thordin9/rp-pico-fan-controller/enclosure/README.md

# Pico W and BMP280 enclosures

Parametric 3D-printed parts for the Pico W fan controller. The cases are for a controlled indoor room: thin walls, no rain awning, no drip loop, and no radiation-shield louvers. One BMP280 body is printed twice; only the lid label changes (`INT` or `EXT`).

Sources are in [`scad/`](scad/). OpenSCAD meshes are in [`stl/`](stl/), previews in [`renders/`](renders/). Matching FreeCAD models are in [`freecad/`](freecad/).

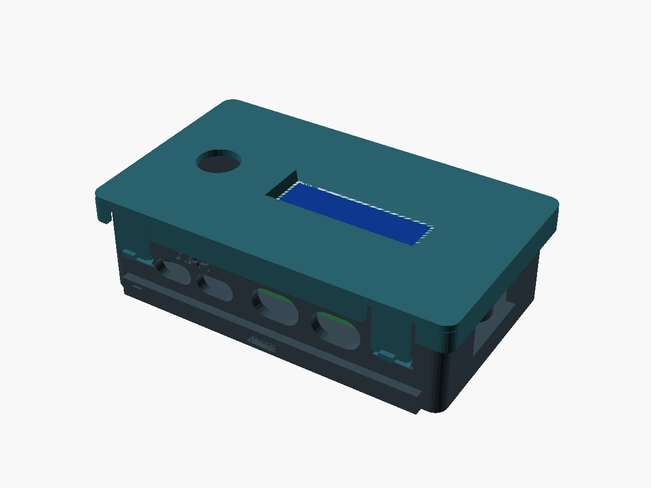
[picture p1: enclosure/renders/pico_case_closed.png]
Pico case, lid closed, OLED in place

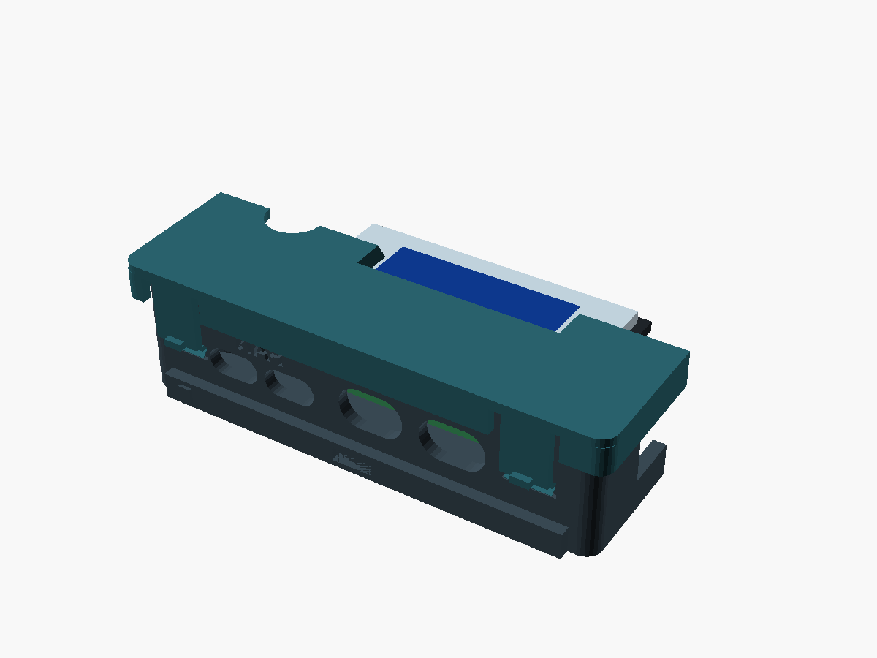
[picture p2: enclosure/renders/pico_case_section.png]
Section through the OLED window

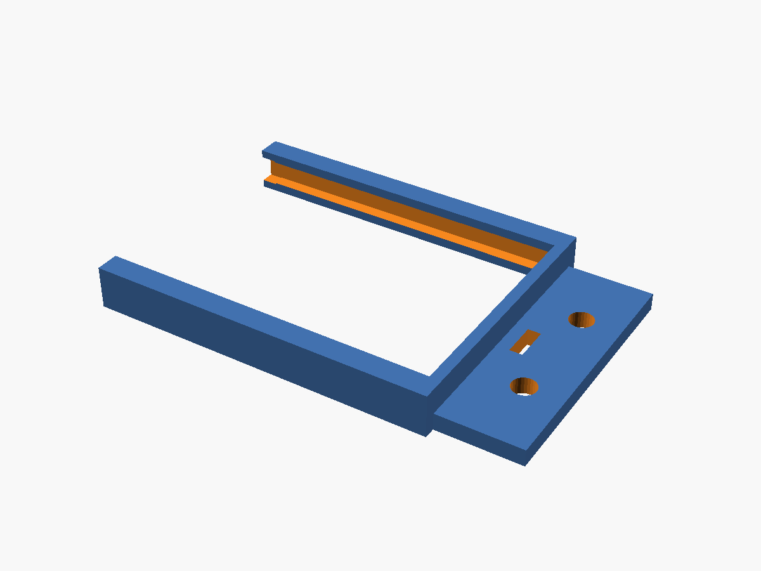
[picture p3: enclosure/renders/mount_pico.png]
Optional Pico wall bracket


## Parts

| Print | STL | Qty | Notes |
| --- | --- | --- | --- |
| Pico case base | [`stl/pico_case_base.stl`](stl/pico_case_base.stl) | 1 | Standoffs, cable exits, slide rails. Flat bottom |
| Pico case lid | [`stl/pico_case_lid.stl`](stl/pico_case_lid.stl) | 1 | Through OLED window with a viewing chamfer, BOOTSEL hole, four latch fingers |
| BMP280 body | [`stl/bmp280_int_body.stl`](stl/bmp280_int_body.stl) | 2 | One print for INT, one for EXT. Same solid |
| BMP280 lid, internal | [`stl/bmp280_int_lid.stl`](stl/bmp280_int_lid.stl) | 1 | Two vents, debossed **INT** |
| BMP280 lid, external | [`stl/bmp280_ext_lid.stl`](stl/bmp280_ext_lid.stl) | 1 | Same vents, debossed **EXT** |
| Pico wall bracket | [`stl/mount_pico.stl`](stl/mount_pico.stl) | 0–1 | Optional. Slides onto the Pico rails |
| BMP280 wall bracket | [`stl/mount_bmp.stl`](stl/mount_bmp.stl) | 0–2 | Optional. One per sensor housing |

`bmp280_ext_body.stl` is the same geometry as the INT body, so either file is the sensor body. `variant` only changes the lid text.

## Old and new outside dimensions

Ears, tabs, the cable awning, and the tall still-air cavity are gone. The slide rails add 1.4 mm per long side and are the only thing the bracket holds. Without a bracket the bottom is flat.

| Part | Previous | Now |
| --- | --- | --- |
| Pico base, body | 63 × 47 × 23 mm | 56.7 × 32.2 × 15.5 mm |
| Pico base, including fixed ears | 63 × 71 × 23 mm | no ears. Rails make the print 56.7 × 35.0 × 15.5 mm |
| Pico lid | 67.3 × 51.3 × 7.0 mm | plate 59.7 × 35.2 × 4.4 mm. Latch fingers bring the print to 59.7 × 36.2 × 10.2 mm |
| BMP280 body | 39.4 × 36.4 × 16.9 mm, plus 16 mm tabs each end (71.4 mm long) | 19.1 × 18.35 × 13.7 mm. Rails make the print 19.1 × 21.15 × 13.7 mm |
| BMP280 lid, INT | 44.3 × 41.3 × 11.9 mm | plate 22.1 × 21.35 × 4.4 mm. Fingers and pull tabs make the print 23.1 × 21.35 × 11.2 mm |
| BMP280 lid, EXT | 46.9 × 43.9 × 11.9 mm, with an eave | same solid as the INT lid, with an EXT label |
| Wall bracket | fixed to the body | separate part. Pico bracket is about 61 × 42 × 6 mm; BMP bracket is about 23 × 28 × 6 mm |

Walls are 1.6 mm (four 0.4 mm perimeters). Floor and lid are 1.2 mm (three perimeters). Pico standoffs are 3.0 mm above the floor. Gutters are 4.0 mm. The antenna end gap is 2.5 mm, with the end wall open across the 14 mm keep-out.

The sensor body used to be 28.6 × 25.6 × 14.5 mm, sized around a 21 × 18 mm board. A purple 15 × 11.5 mm module sat in one corner. The cavity is now that module plus 0.45 mm on the sides and the back, and a 3.2 mm bay on the header edge.

## Dimensions and where they come from

`scad/dimensions.scad` holds every source number. Derived pockets add `fit_clearance` (0.30 mm) per side. OpenSCAD `assert`s fail the export if a pocket, window, snap, or stack-up stops fitting.

| Item | Value | Source |
| --- | --- | --- |
| Pico W PCB | 51 × 21 × 1 mm | Pico W datasheet, section 2 |
| Pico mounting holes | Ø2.1 mm, 47.0 × 11.4 mm pattern | Datasheet figure 3. Insets are (51−47)/2 = 2.0 mm and (21−11.4)/2 = 4.8 mm |
| USB overhang | 1.3 mm typical | Datasheet figure 3. The connector face sits 0.3 mm inside the 1.6 mm end wall, so the plug body stays outside |
| Antenna keep-out | 14 × 9 mm | Datasheet section 2.2.1. The antenna end wall is open across the 14 mm width |
| Header above the PCB | 8.5 mm | Not a datasheet callout. Standard 0.1" pin header. Override `pico_header_above_pcb` |
| BOOTSEL | 7.5 mm from the USB edge of the PCB, on the centreline, Ø7 hole | The drawing does not locate the button. Nudge `pico_bootsel_from_usb_edge` if the hole misses |
| OLED module | 36.0 × 12.5 mm, active area 22.38 × 5.58 mm | Waveshare 0.91" SSD1306 wiki / selection table. The glass is centred on the module (`oled_active_dx` / `oled_active_dy` are 0) |
| OLED window | 22.78 × 5.98 mm through the lid | Active area plus 0.40 mm. A 45° chamfer opens toward the outside face so the pixels stay readable at an angle |
| OLED stack | PCB 1.20 + glass 1.45 = 2.65 mm | Thickness is not published by Waveshare. 1.45 mm is the matching 0.91" 128×32 panel (EastRising ER-OLED0.91-1). Remeasure and set `oled_pcb_t` / `oled_glass_t` |
| BMP280 module | 15 × 11.5 × 1.6 mm, six pins | Purple GY-BMP280-3.3. Sellers list this outline; the repo has no drawing of the hole centres |
| BMP280 mounting holes | Ø2.2 mm, 2.5 mm from each short edge, 2.4 mm from the edge opposite the header | Not on a published drawing. Override `bmp_hole_inset_x` and `bmp_hole_inset_back` if you measure something else. The walls still locate the board if the holes are off |
| BMP280 pin pitch | 2.54 mm, five spaces (12.7 mm) on the 15 mm edge | The 1×6 Dupont shell is 15.24 mm and fits the chamber, not the PCB |
| Walls / floor / lid | 1.6 / 1.2 / 1.2 mm | Four and three 0.4 mm perimeters |
| Slide rail | 1.4 mm thick × 3.2 mm tall | Same section on the Pico case and both sensor bodies. Each rail has a 5.0 × 1.8 mm zip-tie slot and a 0.4 mm detent |

Header plastic width, the micro-USB shell (8.0 × 3.8 mm), and the PH2.0 shroud width (10.5 mm) are named because they are not in those drawings. The PH2.0 plug has to stay narrower than the gap between the Pico header rows (15.24 mm).

The OLED nest is shifted 6 mm toward the antenna so it clears the BOOTSEL hole and the USB shell. In plan it sits inboard of the header plastic (about 0.5 mm). The glass face is against the inner face of the lid, and the window is a hole, not a pocket floor. [`renders/pico_case_closed.png`](renders/pico_case_closed.png) shows the dummy panel through the closed lid. [`renders/pico_case_section.png`](renders/pico_case_section.png) cuts on the active-area centreline.

## Cable routing

Each BMP280 module has six pins: **VCC, GND, SCL, SDA, CSB, SDO**. Tie **CSB to 3V3** before power-up (that forces I2C mode) and **SDO to GND** (address **0x76**). Do this with a wire. The onboard pull resistors are not enough.

- **(a)** A 6-wire cable to the Pico. CSB joins 3V3 pin 36. SDO joins Pico GND.
- **(b)** Short jumpers soldered on the module, CSB to VCC and SDO to GND. The cable stays four wires.

The two boards both end at `0x76`, so they cannot share a bus. The firmware can instead put a sensor at **0x77** on I2C0 when that module's SDO is tied to 3V3. These printed parts are for two `0x76` boards, two buses, and two cable exits. The pin-by-pin wiring is in [docs/wiring.md](../docs/wiring.md).

The sensor housing exit is a through opening, **15.5 × 4.6 mm** with 0.8 mm corners, centred on the pin row. It sits above the slide rails and clear of the bracket. A 1×6 Dupont shell (15.24 mm wide, about 2.5 mm tall) or soldered wires leave through that edge. A bar across the top of the opening bites the side walls and takes one zip tie without filling the hole. [`renders/bmp280_cable_exit.png`](renders/bmp280_cable_exit.png) shows that face.

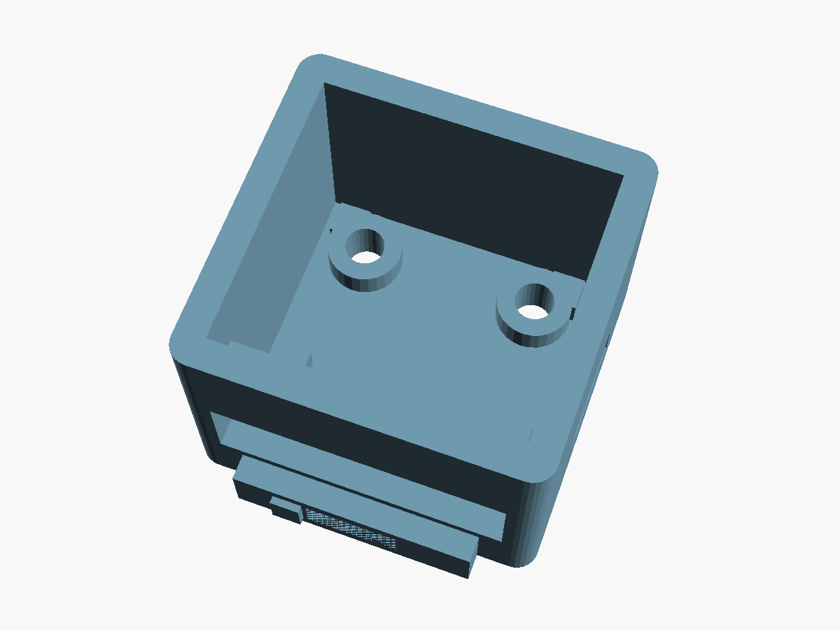
[picture p4: enclosure/renders/bmp280_cable_exit.png]
BMP280 cable exit


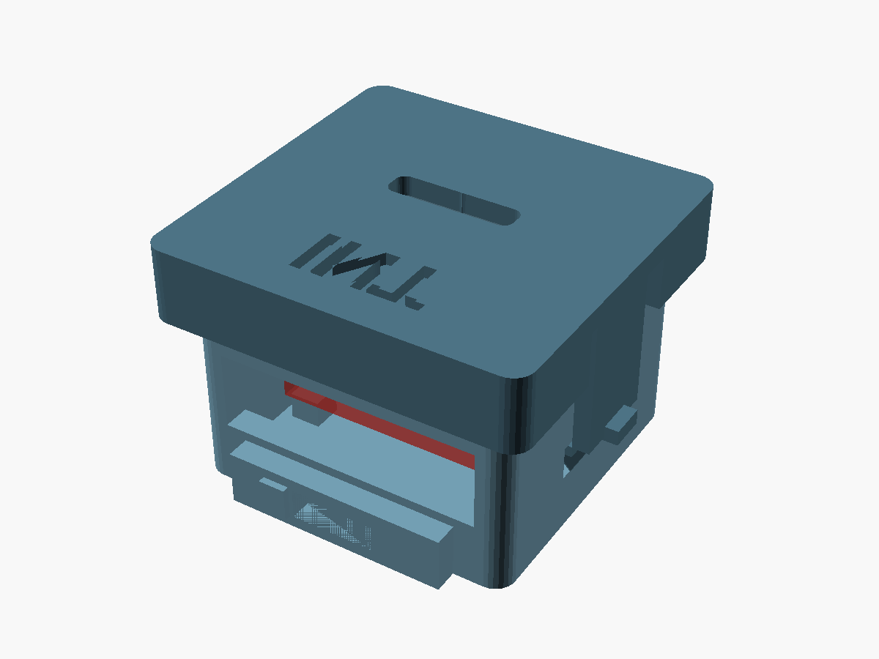
[picture p5: enclosure/renders/bmp280_assembly.png]
BMP280 housing, lid seated


The Pico case has a separate exit for each cable, plus two fan exits and one power exit. INT and EXT are **8.0 × 5.0 mm**, so the 6-wire bundle from option (a) passes after the 1×6 shell stays on the module. The OLED does not use those exits; its PH2.0 lead stays inside the case. Each Pico cleat sits on the top edge of its opening, so the hole stays full height.

| Exit (debossed) | Wall | Lands on | Cable |
| --- | --- | --- | --- |
| **FAN** (two slots) | Cable wall, USB end | GP15–GP18 PWM, GP14–GP11 tach | Split the four fans across the two slots, two fans each. Tach pull-ups are 10 kΩ to Pico **3V3** |
| **INT** | Cable wall | **I2C0: GP4 SDA pin 6, GP5 SCL pin 7** | Internal BMP280. See the pin table below |
| **EXT** | Cable wall, antenna end | **I2C1: GP6 SDA pin 9, GP7 SCL pin 10** | External BMP280. See the pin table below |
| **PWR** | Opposite wall | VSYS and the fan supply | Regulated 5 V into **VSYS (physical pin 39)**, external 12 V for the fans, and the common ground |

### Internal sensor, every module pin

| Module pin | Lands on | Option (a), 6-wire cable out the INT exit | Option (b), jumper on the module |
| --- | --- | --- | --- |
| VCC | Pico 3V3 pin 36 | wire in the cable | wire in the cable |
| GND | Pico GND | wire in the cable | wire in the cable |
| SCL | GP5 pin 7 | wire in the cable | wire in the cable |
| SDA | GP4 pin 6 | wire in the cable | wire in the cable |
| CSB | 3V3, high before power-up | wire in the cable to 3V3 pin 36 | solder CSB to VCC |
| SDO | GND, address `0x76` | wire in the cable to Pico GND | solder SDO to GND |

### External sensor, every module pin

| Module pin | Lands on | Option (a), 6-wire cable out the EXT exit | Option (b), jumper on the module |
| --- | --- | --- | --- |
| VCC | Pico 3V3 pin 36 | wire in the cable | wire in the cable |
| GND | Pico GND | wire in the cable | wire in the cable |
| SCL | GP7 pin 10 | wire in the cable | wire in the cable |
| SDA | GP6 pin 9 | wire in the cable | wire in the cable |
| CSB | 3V3, high before power-up | wire in the cable to 3V3 pin 36 | solder CSB to VCC |
| SDO | GND, address `0x76` | wire in the cable to Pico GND | solder SDO to GND |

The OLED PH2.0 (VCC, GND, SDA, SCL) is plugged inside the case onto the same I2C0 pins as the INT cable: VCC and GND to 3V3 and GND, SDA to GP4, SCL to GP5. It has no CSB or SDO. Parallel the INT cable onto those four points. Do not also connect the EXT cable there. With option (a), the internal CSB shares 3V3 pin 36 and the internal SDO shares a GND pin; they are not OLED signals.

```mermaid
flowchart LR
  subgraph box [Pico case]
    pico["Pico W USB toward the USB opening"]
    oled["OLED 0x3C PH2.0 stays inside"]
  end
  subgraph inside [INT housing in the room]
    bmpI["BMP280 0x76 CSB to 3V3 SDO to GND"]
  end
  subgraph outside [EXT housing in the room]
    bmpE["BMP280 0x76 CSB to 3V3 SDO to GND"]
  end
  fans["12 V fans through the two FAN slots"]
  supply["5 V and 12 V through PWR"]
  pico -->|"INT option a: VCC, GND, SDA GP4 pin 6, SCL GP5 pin 7, CSB to 3V3 pin 36, SDO to GND"| bmpI
  pico -->|"OLED: VCC, GND, SDA, SCL on the same I2C0 points"| oled
  pico -->|"EXT option a: VCC, GND, SDA GP6 pin 9, SCL GP7 pin 10, CSB to 3V3 pin 36, SDO to GND"| bmpE
  pico -->|"FAN: PWM GP15-GP18, tach GP14 GP13 GP12 GP11"| fans
  supply -->|"VSYS pin 39 and common GND"| pico
  supply -->|"12 V to fan pin 2, GND to fan pin 1"| fans
```

Option (b) uses the same exits. CSB and SDO stop at the jumpers on the module, and the cable through INT or EXT is VCC, GND, SCL, SDA.

Physical pin numbers use the Pico pinout with USB at the top: pin 1 is GP0, pin 40 is VBUS. Fan tach pull-ups are 10 kΩ to Pico 3V3 pin 36, one resistor per tach wire.

Fan power and tach rules match the controller [wiring guide](../docs/wiring.md): fans take 12 V from their own supply, never from the Pico; 5 V into VSYS pin 39 only; one common ground. Do not feed 5 V into 3V3 pin 36.

## Where to put the sensors

Both housings are the same shape. Put the **INT** lid on the one that shares the OLED bus, and the **EXT** lid on the one that has I2C1 to itself.

- Out of the fan blast, and away from the motor body, the Pico regulator, and the 12 V wiring.
- Lid up. The board stands on corner pads and two bosses around the M2 holes, so it is not shorted to the plastic. The side walls and the back wall locate it; the header edge stays open for the plug.
- The lid vents are open slots. They are not a weather shield. These parts are for an indoor room.

## Using the case with and without the bracket

The bodies have no mounting ears and no tabs. The bottom is flat, so a case can sit on a desk or take a pad of double-sided tape.

Each long wall has a slide rail with a zip-tie slot (5.0 × 1.8 mm). A tie through that slot holds the case to a grille or a shelf without the bracket.

The bracket is a separate print. Slide it onto the rails from the USB end (Pico) or the cable end (BMP280) until it stops. The 0.4 mm detent is what the jaw flexes over; pull straight back off to remove it. The flange takes two M3 screws or one zip tie. The bracket does not go under the case, so the case still sits flat while the flange sticks out at one end.

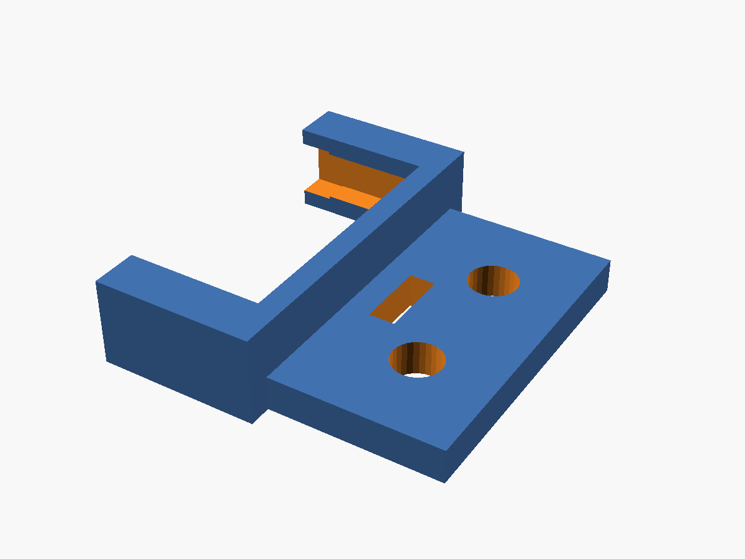
[picture p6: enclosure/renders/mount_bmp.png]
BMP280 bracket


## Hardware

Heat-set inserts are M2, 3.5 mm OD × 3 mm long (short Ruthex-style). The printed hole is Ø3.2 mm × 3.6 mm deep. The lid snaps on; it does not use screws.

| Qty | Fastener | Where |
| --- | --- | --- |
| 4 | M2 insert 3.5 × 3 mm | Pico standoffs, pressed in from **below**, before the board goes in |
| 4 | M2×4 pan head | Down through the Pico's own holes into the standoffs. The insert starts 0.6 mm under the standoff top, so about 2.4 mm of thread enters the pocket. An M2×5 bottoms out |
| 0–6 | M3 pan head, or zip ties | Optional brackets only. Two M3 holes and one zip slot per bracket. Clearance is Ø3.4 mm |
| 0–4 | Zip ties, 5.0 × 1.8 mm slot | Through the slide rails when a bracket is not used |
| 7 | Small zip ties | Five Pico exits (two FAN, INT, EXT, PWR) and one cable cleat in each sensor housing |

The lids snap on. Each finger is 1.0 mm thick, with a 45° lead-in and 0.20 mm of interference once the hook sits in the recess. The BMP280 lid has one finger on each short end (8.45 mm arm). The Pico lid has two fingers on each long side (7.45 mm arm), above the bracket jaw and clear of the cable slots. There is no screw boss on the lids.

To close a lid, press it on until the fingers click. To open it, pinch the pull tabs on the fingers and lift. A fingernail notch on the wall opposite the cable exit is the other way to start the lid off.

## Print settings and orientation

- Nozzle 0.4 mm, layer 0.20 mm, **4 perimeters** on the 1.6 mm walls (3 on the 1.2 mm floor and lid), 4 top/bottom layers, 20% infill.
- PLA or PETG. Indoor parts; colour does not matter for the sensor.
- **No supports.** Bodies sit on the bed as modelled (floor and rails down). Cable slots are horizontal openings. The latch recess is a side pocket.
- Sensor lids and the Pico lid are modelled **outer face down, fingers pointing up**. Print them that way. Do not flip a lid onto its skirt: the hooks would land on the bed. The lead-in is a 45° overhang under 1 mm, and each pull tab sticks out 0.8 mm. The OLED chamfer is the wide opening on the bed and closes at 45°. The debossed INT/EXT mark faces the bed; it is only 0.45 mm deep.
- The Pico lid's OLED clips are small ledges inside the nest. If a clip fails, print that lid slower with more cooling rather than adding support under the nest.
- Brackets print flange-down, jaws up. The groove is open toward the case. The top lip bridges 1.7 mm, which a 0.4 mm nozzle does without support.

## Assembly

1. Press four inserts into the Pico standoffs from the **bottom** of the base. Seat them flush. Do this before the board goes in.
2. Set the Pico on the standoffs, USB toward the USB opening, antenna toward the open end wall. M2×4 down through the Pico holes.
3. Fan leads out the two **FAN** slots, INT cable out **INT**, EXT cable out **EXT**, 5 V and 12 V in through **PWR**. One zip tie per cleat.
4. Plug the OLED into I2C0 (GP4/GP5, 3V3, GND) and slide the module into the lid nest, glass toward the window, PH2.0 toward the USB end. The clips grab the back of the PCB. With the lid closed the active area is the hole in the lid; the chamfer is the wider opening on the outside.
5. Press the Pico lid on until the four fingers click. Pinch a pull tab on each long side to take it off. BOOTSEL is the round hole near the USB end of the lid. The fingernail notch is on the long side opposite the cable wall.
6. Sensor boards sit on the pads, pin row toward the cable slot, chip up. Option (a) sends six wires out the 15.5 × 4.6 mm exit. Option (b) solders CSB to VCC and SDO to GND on the module, and four wires leave. Zip-tie the lead under the bar. Press the lid on until the two end fingers click. Pinch the pull tabs to take it off. The fingernail notch is opposite the cable side.
7. Leave the case on its flat bottom, tape it down, zip-tie it through the rail slots, or slide a bracket on from the open end of the rails and screw the flange to the wall.

## Adjusting the model

From `enclosure/`:

```bash
./export.sh
```

`QUALITY=32 ./export.sh` is a faster mesh. The default is 48. The script refuses a mesh that is not a single shell, and it checks that the USB opening, the separate INT and EXT exits, the FAN and PWR exits, the OLED window, the BOOTSEL hole, the sensor cable slot, and the lid vents are actually open. Each of those cable checks includes a point past the inner face, so a blind recess fails.

Overrides are normal OpenSCAD `-D` flags, for example:

```bash
openscad -D 'fit_clearance=0.40' -D 'variant="EXT"' -D 'part="lid"' \
  -o /tmp/ext.stl --export-format binstl scad/bmp280_housing.scad
```

| Knob | What it does |
| --- | --- |
| `fit_clearance` | Extra room per side on the OLED pocket. Keep it between 0.20 and 0.60 mm |
| `pico_header_above_pcb` | Raise this if your headers are taller than 8.5 mm. The case grows with it |
| `pico_bootsel_from_usb_edge` | Move the BOOTSEL hole along the board. The OLED nest must stay clear of it |
| `oled_pcb_t`, `oled_glass_t` | Stack height if you remeasure the module. The glass is seated against the lid |
| `oled_active_dx`, `oled_active_dy` | Shift the window if the pixels are not centred on your module |
| `bmp_air` | Side and back clearance around the 15 × 11.5 mm module. Keep it between 0.30 and 0.50 mm |
| `bmp_pcb_l`, `bmp_pcb_w` | Module outline if yours is not 15 × 11.5 mm. The body, the lid, and the bracket follow |
| `bmp_header_bay` | Room in front of the pin row for a Dupont plug or soldered wires |
| `bmp_hole_inset_x`, `bmp_hole_inset_back` | Move the M2 holes if you measure different centres |
| `bmp_pcb_t`, `bmp_pin_pitch` | If your module is not 1.6 mm or the row is not 2.54 mm |
| `pico_standoff_h` | More room under the board for solder tails. The datasheet notes solder under the USB connector can hold a bare board off the table |
| `variant`, `part`, `which` | `"INT"` / `"EXT"`, `"body"` / `"lid"` / `"assembly"` / `"section"` / `"closed"`, and `"pico"` / `"bmp"` for the bracket |

`assembly`, `closed`, and `section` are previews, not print files. The Pico section cuts through the OLED centreline and leaves a dummy module in the nest so the chamfer and the glass are visible.
