thordin9/rp-pico-fan-controller/enclosure/freecad/dof-report.txt

pico_case_base	shell	DoF=0	solve=0	fully_constrained=True	redundant=[]	conflicting=[]	malformed=[]	partial=[]	status=Valid
pico_case_base	shell_round	DoF=0	solve=0	fully_constrained=True	redundant=[]	conflicting=[]	malformed=[]	partial=[]	status=Valid
pico_case_base	rail_n	DoF=0	solve=0	fully_constrained=True	redundant=[]	conflicting=[]	malformed=[]	partial=[]	status=Valid
pico_case_base	rail_p	DoF=0	solve=0	fully_constrained=True	redundant=[]	conflicting=[]	malformed=[]	partial=[]	status=Valid
pico_case_base	zip_n	DoF=0	solve=0	fully_constrained=True	redundant=[]	conflicting=[]	malformed=[]	partial=[]	status=Valid
pico_case_base	zip_p	DoF=0	solve=0	fully_constrained=True	redundant=[]	conflicting=[]	malformed=[]	partial=[]	status=Valid
pico_case_base	det_n	DoF=0	solve=0	fully_constrained=True	redundant=[]	conflicting=[]	malformed=[]	partial=[]	status=Valid
pico_case_base	det_p	DoF=0	solve=0	fully_constrained=True	redundant=[]	conflicting=[]	malformed=[]	partial=[]	status=Valid
pico_case_base	cavity	DoF=0	solve=0	fully_constrained=True	redundant=[]	conflicting=[]	malformed=[]	partial=[]	status=Valid
pico_case_base	usb	DoF=0	solve=0	fully_constrained=True	redundant=[]	conflicting=[]	malformed=[]	partial=[]	status=Valid
pico_case_base	usb_round	DoF=0	solve=0	fully_constrained=True	redundant=[]	conflicting=[]	malformed=[]	partial=[]	status=Valid
pico_case_base	antenna	DoF=0	solve=0	fully_constrained=True	redundant=[]	conflicting=[]	malformed=[]	partial=[]	status=Valid
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
bmp280_ext_body	screw_1	DoF=0	solve=0	fully_constrained=True	redundant=[]	conflicting=[]	malformed=[]	partial=[]	status=Valid
bmp280_ext_body	bar	DoF=0	solve=0	fully_constrained=True	redundant=[]	conflicting=[]	malformed=[]	partial=[]	status=Valid
bmp280_ext_body	lr0	DoF=0	solve=0	fully_constrained=True	redundant=[]	conflicting=[]	malformed=[]	partial=[]	status=Valid
bmp280_ext_body	lr1	DoF=0	solve=0	fully_constrained=True	redundant=[]	conflicting=[]	malformed=[]	partial=[]	status=Valid
RESULT	bmp280_ext_body	volume_solid=1806.134	volume_openscad_stl=1808.635	delta=-2.501	rel=0.001383	bbox_delta=0.0000	probes=6
bmp280_int_lid	plate	DoF=0	solve=0	fully_constrained=True	redundant=[]	conflicting=[]	malformed=[]	partial=[]	status=Valid
bmp280_int_lid	plate_round	DoF=0	solve=0	fully_constrained=True	redundant=[]	conflicting=[]	malformed=[]	partial=[]	status=Valid
bmp280_int_lid	skirt	DoF=0	solve=0	fully_constrained=True	redundant=[]	conflicting=[]	malformed=[]	partial=[]	status=Valid
bmp280_int_lid	skirt_round	DoF=0	solve=0	fully_constrained=True	redundant=[]	conflicting=[]	malformed=[]	partial=[]	status=Valid
bmp280_int_lid	skirt_void	DoF=0	solve=0	fully_constrained=True	redundant=[]	conflicting=[]	malformed=[]	partial=[]	status=Valid
bmp280_int_lid	ls0	DoF=0	solve=0	fully_constrained=True	redundant=[]	conflicting=[]	malformed=[]	partial=[]	status=Valid
bmp280_int_lid	ls1	DoF=0	solve=0	fully_constrained=True	redundant=[]	conflicting=[]	malformed=[]	partial=[]	status=Valid
bmp280_int_lid	lf0	DoF=0	solve=0	fully_constrained=True	redundant=[]	conflicting=[]	malformed=[]	partial=[]	status=Valid
bmp280_int_lid	lf0h	DoF=0	solve=0	fully_constrained=True	redundant=[]	conflicting=[]	malformed=[]	partial=[]	status=Valid
bmp280_int_lid	lf0t	DoF=0	solve=0	fully_constrained=True	redundant=[]	conflicting=[]	malformed=[]	partial=[]	status=Valid
bmp280_int_lid	lf1	DoF=0	solve=0	fully_constrained=True	redundant=[]	conflicting=[]	malformed=[]	partial=[]	status=Valid
bmp280_int_lid	lf1h	DoF=0	solve=0	fully_constrained=True	redundant=[]	conflicting=[]	malformed=[]	partial=[]	status=Valid
bmp280_int_lid	lf1t	DoF=0	solve=0	fully_constrained=True	redundant=[]	conflicting=[]	malformed=[]	partial=[]	status=Valid
bmp280_int_lid	vent_0	DoF=0	solve=0	fully_constrained=True	redundant=[]	conflicting=[]	malformed=[]	partial=[]	status=Valid
bmp280_int_lid	vent_0_round	DoF=0	solve=0	fully_constrained=True	redundant=[]	conflicting=[]	malformed=[]	partial=[]	status=Valid
bmp280_int_lid	vent_1	DoF=0	solve=0	fully_constrained=True	redundant=[]	conflicting=[]	malformed=[]	partial=[]	status=Valid
bmp280_int_lid	vent_1_round	DoF=0	solve=0	fully_constrained=True	redundant=[]	conflicting=[]	malformed=[]	partial=[]	status=Valid
bmp280_int_lid	notch	DoF=0	solve=0	fully_constrained=True	redundant=[]	conflicting=[]	malformed=[]	partial=[]	status=Valid
RESULT	bmp280_int_lid	volume_solid=879.157	volume_openscad_stl=874.014	delta=5.142	rel=0.005884	bbox_delta=0.0100	probes=5
bmp280_ext_lid	plate	DoF=0	solve=0	fully_constrained=True	redundant=[]	conflicting=[]	malformed=[]	partial=[]	status=Valid
bmp280_ext_lid	plate_round	DoF=0	solve=0	fully_constrained=True	redundant=[]	conflicting=[]	malformed=[]	partial=[]	status=Valid
bmp280_ext_lid	skirt	DoF=0	solve=0	fully_constrained=True	redundant=[]	conflicting=[]	malformed=[]	partial=[]	status=Valid
bmp280_ext_lid	skirt_round	DoF=0	solve=0	fully_constrained=True	redundant=[]	conflicting=[]	malformed=[]	partial=[]	status=Valid
bmp280_ext_lid	skirt_void	DoF=0	solve=0	fully_constrained=True	redundant=[]	conflicting=[]	malformed=[]	partial=[]	status=Valid
bmp280_ext_lid	ls0	DoF=0	solve=0	fully_constrained=True	redundant=[]	conflicting=[]	malformed=[]	partial=[]	status=Valid
bmp280_ext_lid	ls1	DoF=0	solve=0	fully_constrained=True	redundant=[]	conflicting=[]	malformed=[]	partial=[]	status=Valid
bmp280_ext_lid	lf0	DoF=0	solve=0	fully_constrained=True	redundant=[]	conflicting=[]	malformed=[]	partial=[]	status=Valid
bmp280_ext_lid	lf0h	DoF=0	solve=0	fully_constrained=True	redundant=[]	conflicting=[]	malformed=[]	partial=[]	status=Valid
bmp280_ext_lid	lf0t	DoF=0	solve=0	fully_constrained=True	redundant=[]	conflicting=[]	malformed=[]	partial=[]	status=Valid
bmp280_ext_lid	lf1	DoF=0	solve=0	fully_constrained=True	redundant=[]	conflicting=[]	malformed=[]	partial=[]	status=Valid
bmp280_ext_lid	lf1h	DoF=0	solve=0	fully_constrained=True	redundant=[]	conflicting=[]	malformed=[]	partial=[]	status=Valid
bmp280_ext_lid	lf1t	DoF=0	solve=0	fully_constrained=True	redundant=[]	conflicting=[]	malformed=[]	partial=[]	status=Valid
bmp280_ext_lid	vent_0	DoF=0	solve=0	fully_constrained=True	redundant=[]	conflicting=[]	malformed=[]	partial=[]	status=Valid
bmp280_ext_lid	vent_0_round	DoF=0	solve=0	fully_constrained=True	redundant=[]	conflicting=[]	malformed=[]	partial=[]	status=Valid
bmp280_ext_lid	vent_1	DoF=0	solve=0	fully_constrained=True	redundant=[]	conflicting=[]	malformed=[]	partial=[]	status=Valid
bmp280_ext_lid	vent_1_round	DoF=0	solve=0	fully_constrained=True	redundant=[]	conflicting=[]	malformed=[]	partial=[]	status=Valid
bmp280_ext_lid	notch	DoF=0	solve=0	fully_constrained=True	redundant=[]	conflicting=[]	malformed=[]	partial=[]	status=Valid
RESULT	bmp280_ext_lid	volume_solid=877.631	volume_openscad_stl=872.604	delta=5.027	rel=0.005761	bbox_delta=0.0100	probes=4
mount_pico	jaw0	DoF=0	solve=0	fully_constrained=True	redundant=[]	conflicting=[]	malformed=[]	partial=[]	status=Valid
mount_pico	stop	DoF=0	solve=0	fully_constrained=True	redundant=[]	conflicting=[]	malformed=[]	partial=[]	status=Valid
mount_pico	jaw1	DoF=0	solve=0	fully_constrained=True	redundant=[]	conflicting=[]	malformed=[]	partial=[]	status=Valid
mount_pico	flange	DoF=0	solve=0	fully_constrained=True	redundant=[]	conflicting=[]	malformed=[]	partial=[]	status=Valid
mount_pico	groove0	DoF=0	solve=0	fully_constrained=True	redundant=[]	conflicting=[]	malformed=[]	partial=[]	status=Valid
mount_pico	lead0	DoF=0	solve=0	fully_constrained=True	redundant=[]	conflicting=[]	malformed=[]	partial=[]	status=Valid
mount_pico	groove1	DoF=0	solve=0	fully_constrained=True	redundant=[]	conflicting=[]	malformed=[]	partial=[]	status=Valid
mount_pico	lead1	DoF=0	solve=0	fully_constrained=True	redundant=[]	conflicting=[]	malformed=[]	partial=[]	status=Valid
mount_pico	screw_0	DoF=0	solve=0	fully_constrained=True	redundant=[]	conflicting=[]	malformed=[]	partial=[]	status=Valid
mount_pico	screw_1	DoF=0	solve=0	fully_constrained=True	redundant=[]	conflicting=[]	malformed=[]	partial=[]	status=Valid
mount_pico	fzip	DoF=0	solve=0	fully_constrained=True	redundant=[]	conflicting=[]	malformed=[]	partial=[]	status=Valid
RESULT	mount_pico	volume_solid=2656.798	volume_openscad_stl=2658.616	delta=-1.818	rel=0.000684	bbox_delta=0.0000	probes=3
mount_bmp	jaw0	DoF=0	solve=0	fully_constrained=True	redundant=[]	conflicting=[]	malformed=[]	partial=[]	status=Valid
mount_bmp	stop	DoF=0	solve=0	fully_constrained=True	redundant=[]	conflicting=[]	malformed=[]	partial=[]	status=Valid
mount_bmp	jaw1	DoF=0	solve=0	fully_constrained=True	redundant=[]	conflicting=[]	malformed=[]	partial=[]	status=Valid
mount_bmp	flange	DoF=0	solve=0	fully_constrained=True	redundant=[]	conflicting=[]	malformed=[]	partial=[]	status=Valid
mount_bmp	groove0	DoF=0	solve=0	fully_constrained=True	redundant=[]	conflicting=[]	malformed=[]	partial=[]	status=Valid
mount_bmp	lead0	DoF=0	solve=0	fully_constrained=True	redundant=[]	conflicting=[]	malformed=[]	partial=[]	status=Valid
mount_bmp	groove1	DoF=0	solve=0	fully_constrained=True	redundant=[]	conflicting=[]	malformed=[]	partial=[]	status=Valid
mount_bmp	lead1	DoF=0	solve=0	fully_constrained=True	redundant=[]	conflicting=[]	malformed=[]	partial=[]	status=Valid
mount_bmp	screw_0	DoF=0	solve=0	fully_constrained=True	redundant=[]	conflicting=[]	malformed=[]	partial=[]	status=Valid
mount_bmp	screw_1	DoF=0	solve=0	fully_constrained=True	redundant=[]	conflicting=[]	malformed=[]	partial=[]	status=Valid
mount_bmp	fzip	DoF=0	solve=0	fully_constrained=True	redundant=[]	conflicting=[]	malformed=[]	partial=[]	status=Valid
RESULT	mount_bmp	volume_solid=1063.530	volume_openscad_stl=1065.348	delta=-1.818	rel=0.001706	bbox_delta=0.0000	probes=2
