thordin9/rp-pico-fan-controller/enclosure/freecad/renders/bmp280_ext_body.png

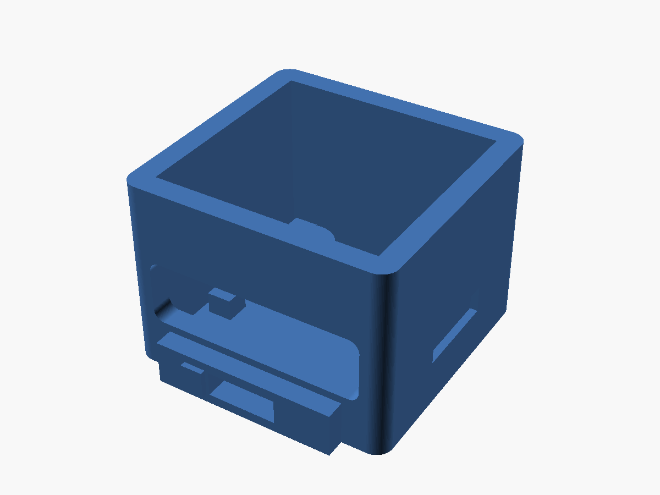
enclosure/freecad/renders/bmp280_ext_body.png
