thordin9/rp-pico-fan-controller/enclosure/freecad/renders/bmp280_ext_lid.png

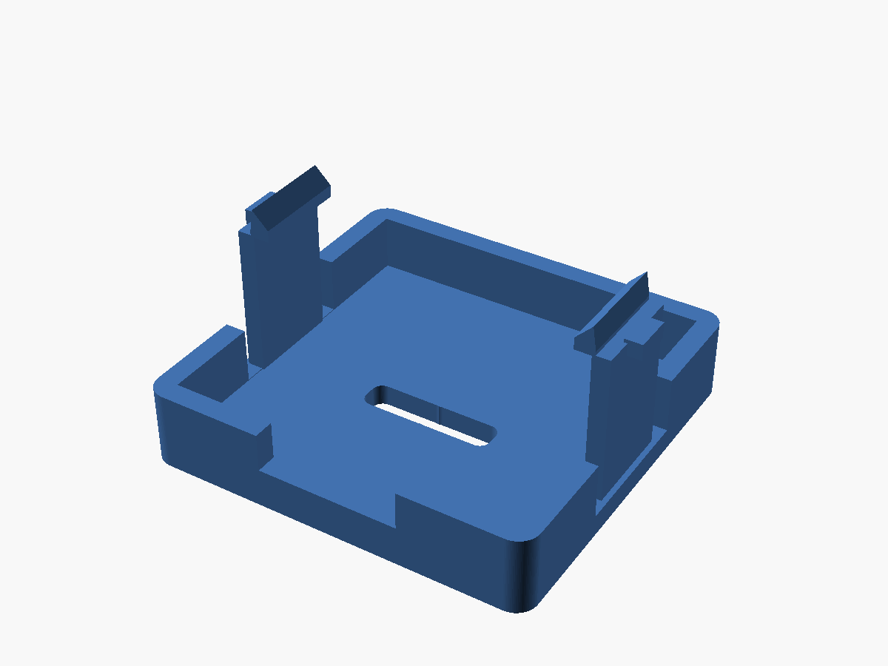
enclosure/freecad/renders/bmp280_ext_lid.png
