thordin9/rp-pico-fan-controller/enclosure/freecad/renders/pico_case_base.png

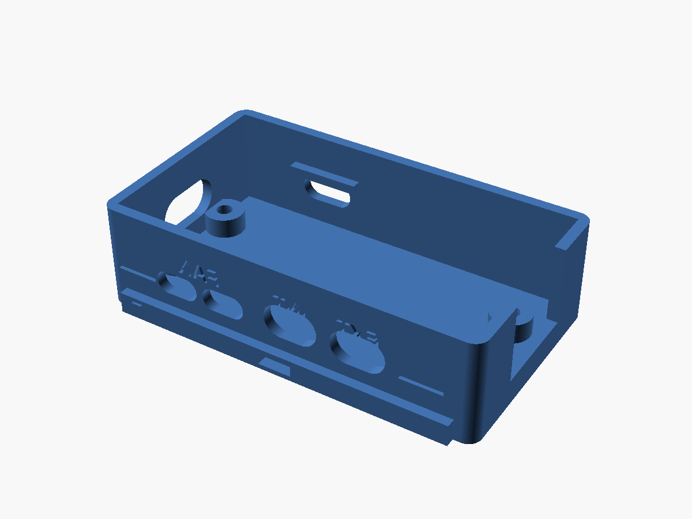
enclosure/freecad/renders/pico_case_base.png
