thordin9/rp-pico-fan-controller/enclosure/freecad/renders/pico_case_lid.png

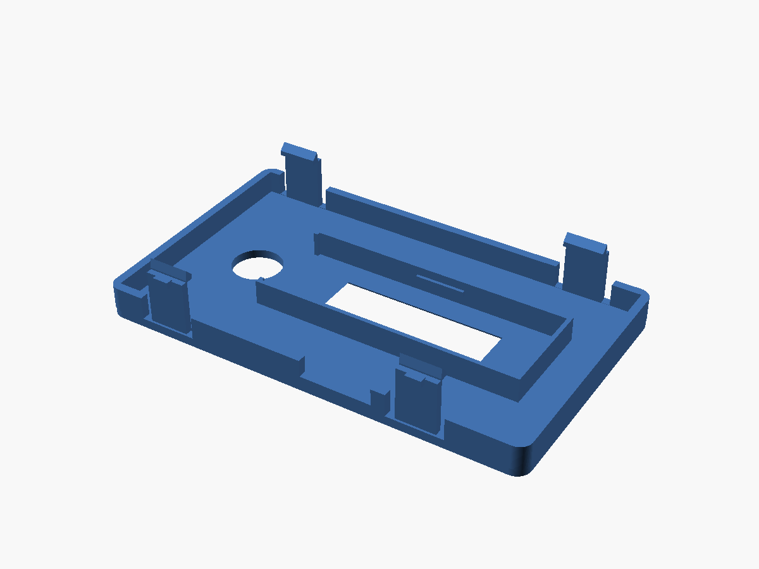
enclosure/freecad/renders/pico_case_lid.png
