thordin9/rp-pico-fan-controller/enclosure/renders/bmp280_ext_lid.png

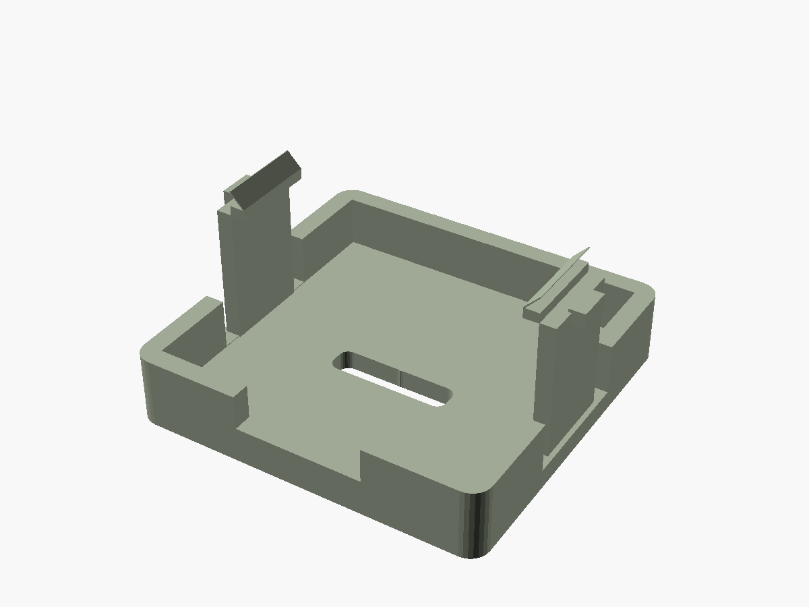
enclosure/renders/bmp280_ext_lid.png
