thordin9/rp-pico-fan-controller/enclosure/renders/bmp280_section.png

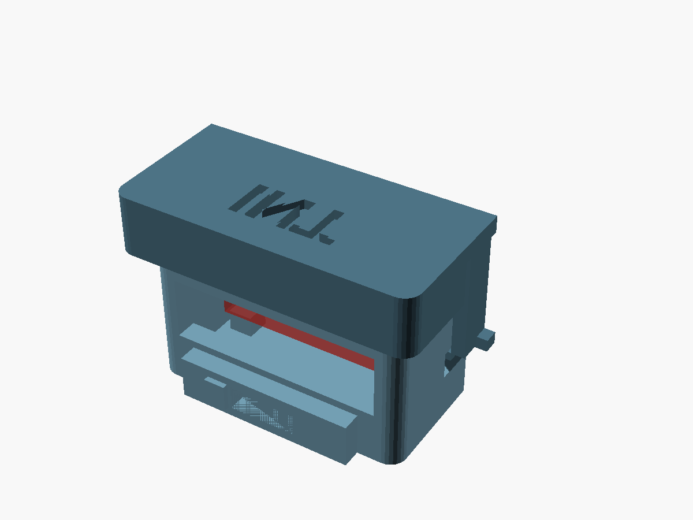
enclosure/renders/bmp280_section.png
