thordin9/rp-pico-fan-controller/enclosure/freecad/step/mount_pico.step

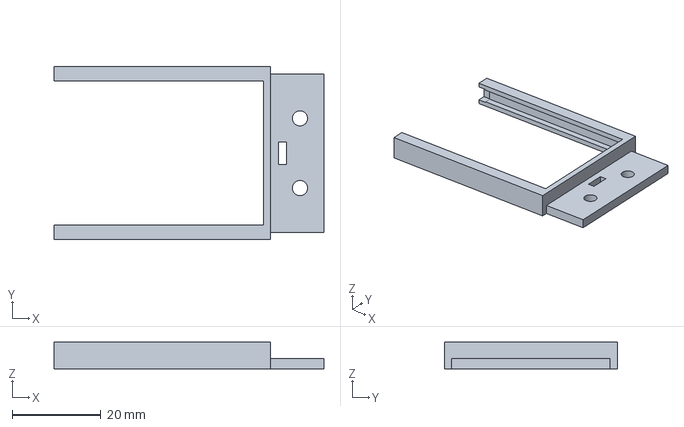
[picture p13: CAD file, 2026-10-22]
enclosure/freecad/step/mount_pico.step
60.7 x 38.9 x 6.05 mm
