thordin9/rp-pico-fan-controller/enclosure/freecad/step/bmp280_int_body.step

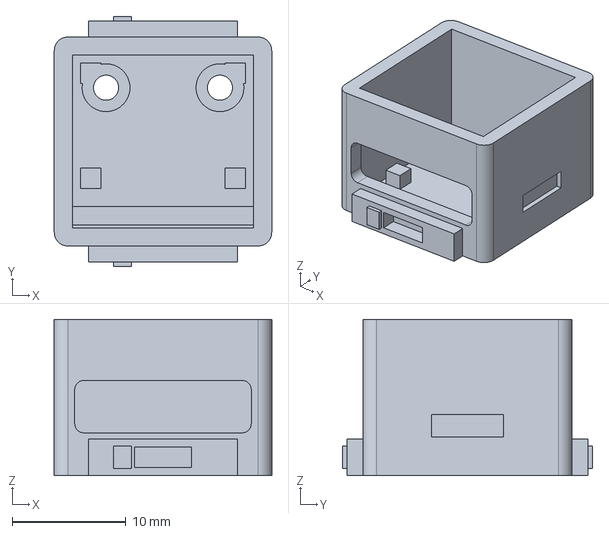
[picture p14: CAD file, 2026-10-22]
enclosure/freecad/step/bmp280_int_body.step
19.1 x 21.9 x 13.7 mm
