thordin9/rp-pico-fan-controller/enclosure/freecad/step/pico_case_base.step

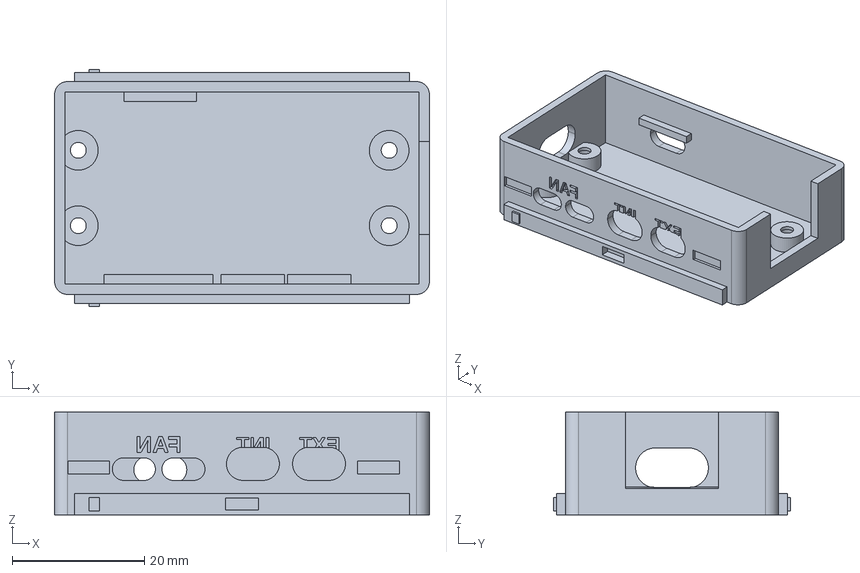
[picture p15: CAD file, 2026-10-22]
enclosure/freecad/step/pico_case_base.step
56.7 x 35.8 x 15.5 mm
