thordin9/rp-pico-fan-controller/enclosure/freecad/step/bmp280_ext_lid.step

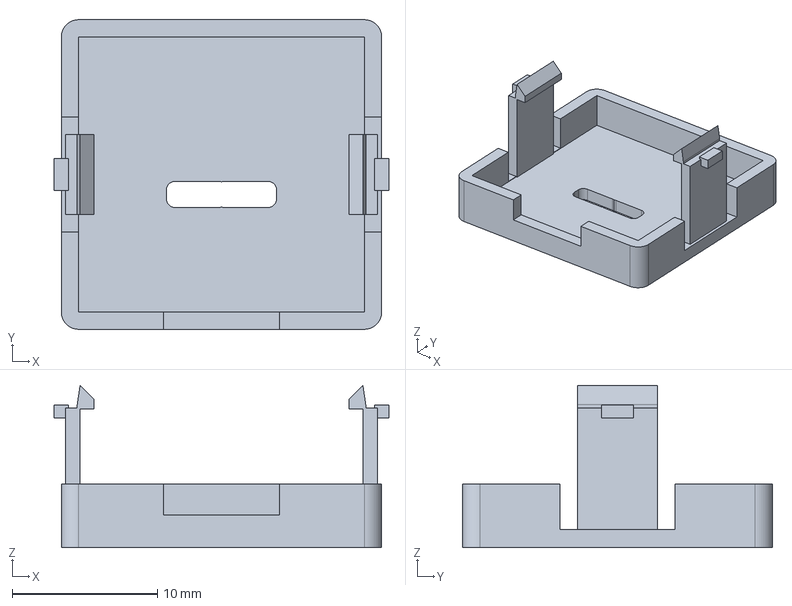
[picture p16: CAD file, 2026-10-22]
enclosure/freecad/step/bmp280_ext_lid.step
23.1 x 21.4 x 11.2 mm
