thordin9/rp-pico-fan-controller/enclosure/freecad/step/pico_case_lid.step

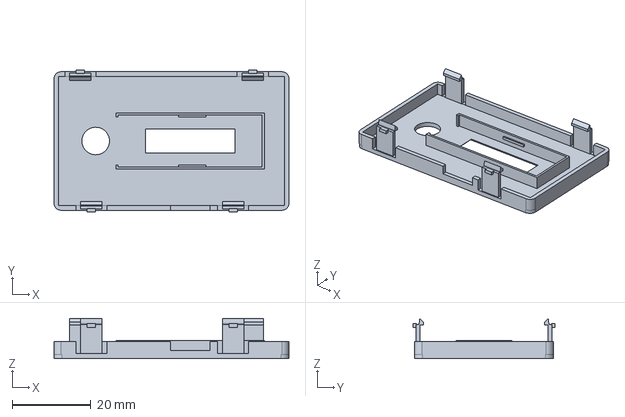
[picture p17: CAD file, 2026-10-22]
enclosure/freecad/step/pico_case_lid.step
59.7 x 36.2 x 10.2 mm
