thordin9/rp-pico-fan-controller/enclosure/freecad/step/mount_bmp.step

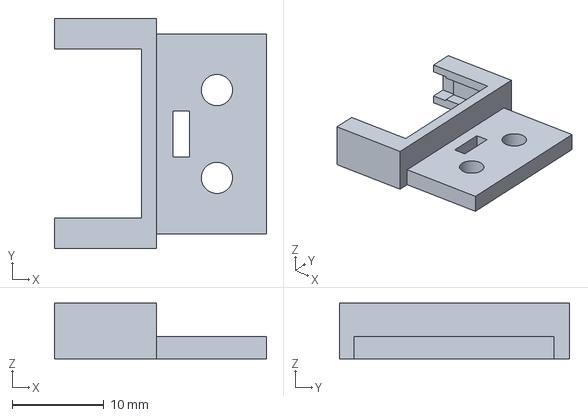
[picture p18: CAD file, 2026-10-22]
enclosure/freecad/step/mount_bmp.step
23.1 x 25.1 x 6.05 mm
