thordin9/rp-pico-fan-controller/(list of files, cad)

Other CAD files:
enclosure/freecad/step/bmp280_ext_body.step
enclosure/freecad/step/bmp280_int_lid.step
enclosure/freecad/bmp280_ext_body.FCStd
enclosure/freecad/bmp280_ext_lid.FCStd
enclosure/freecad/bmp280_int_body.FCStd
enclosure/freecad/bmp280_int_lid.FCStd
enclosure/freecad/mount_bmp.FCStd
enclosure/freecad/mount_pico.FCStd
enclosure/freecad/pico_case_base.FCStd
enclosure/freecad/pico_case_lid.FCStd
enclosure/freecad/stl/bmp280_ext_body.stl
enclosure/freecad/stl/bmp280_ext_lid.stl
enclosure/freecad/stl/bmp280_int_body.stl
enclosure/freecad/stl/bmp280_int_lid.stl
enclosure/freecad/stl/mount_bmp.stl
enclosure/freecad/stl/mount_pico.stl
enclosure/freecad/stl/pico_case_base.stl
enclosure/freecad/stl/pico_case_lid.stl
enclosure/stl/bmp280_ext_body.stl
enclosure/stl/bmp280_ext_lid.stl
enclosure/stl/bmp280_int_body.stl
enclosure/stl/bmp280_int_lid.stl
enclosure/stl/mount_bmp.stl
enclosure/stl/mount_pico.stl
enclosure/stl/pico_case_base.stl
enclosure/stl/pico_case_lid.stl
