thordin9/rp-pico-fan-controller/main.py

"""
Raspberry Pi Pico W — 4-fan thermal PWM controller + web control + Prometheus.

Per-fan PWM (GP15–18) with independent tach (GP14–11). Auto fans follow the
die-temp curve, or the internal BMP280 when that sensor is healthy. Manual
overrides persist in overrides.json. Optional Wi-Fi serves / (control UI),
/status.json, and /metrics.

Fans are brought up before any network wait. Wi-Fi association is polled
from the main loop so a dropout reconnects without blocking fan control.
"""

import gc
import time
import machine

try:
    import config
except ImportError:
    config = None

import fan
from web import HttpServer, resolve_auth, AUTH_DISABLED_WARNING
import metrics
import wifi
import settings as settings_mod
import sensors as sensors_mod
import display as display_mod

HTTP_POLL_MS = 50
HTTP_RESTART_MS = 2000
WIFI_POLL_MS = 500
# RP2040 watchdog is a 24-bit counter at 1 µs. MicroPython rejects above this.
WDT_HW_MAX_MS = 8388

_ctrl = None
_wdt = None


def _feed_wdt():
    if _wdt is not None:
        _wdt.feed()


def _make_led():
    try:
        return machine.Pin("LED", machine.Pin.OUT)
    except (ValueError, TypeError, AttributeError):
        return machine.Pin(25, machine.Pin.OUT)


def _cfg(name, default):
    if config is None:
        return default
    return getattr(config, name, default)


def clamp_wdt_timeout_ms(timeout_ms, hw_max=WDT_HW_MAX_MS):
    """Clamp a requested watchdog timeout into the RP2040's legal range."""
    try:
        timeout = int(timeout_ms)
    except (TypeError, ValueError):
        return None
    if timeout > hw_max:
        return hw_max
    if timeout < 1:
        return 1
    return timeout


def _wifi_wanted(enabled, ssid):
    if not enabled:
        return False
    ssid = ssid or ""
    if not ssid or ssid == "YOUR_SSID":
        return False
    return True


def _start_wdt(enabled=True, requested=8000):
    global _wdt
    if not enabled:
        print("WDT: disabled in config")
        _wdt = None
        return None
    timeout = clamp_wdt_timeout_ms(requested)
    if timeout is None:
        print("WDT: invalid timeout {!r}; watchdog not started".format(requested))
        _wdt = None
        return None
    if timeout != int(requested):
        print(
            "WDT: timeout {} ms adjusted to {} ms (RP2040 allows 1..{})".format(
                requested, timeout, WDT_HW_MAX_MS
            )
        )
    try:
        _wdt = machine.WDT(timeout=timeout)
    except Exception as exc:
        print("WDT: not started:", exc)
        _wdt = None
        return None
    print("WDT: armed, timeout {} ms".format(timeout))
    _feed_wdt()
    return _wdt


def _open_wlan():
    import network

    wlan = network.WLAN(network.STA_IF)
    wlan.active(True)
    return wlan


def _host_for_url(ip, port):
    if int(port) == 80:
        return str(ip)
    return "{}:{}".format(ip, port)


def _start_http(ctrl, auth, port, metrics_require_auth):
    http = HttpServer(
        ctrl,
        metrics,
        auth=auth,
        metrics_require_auth=bool(metrics_require_auth),
    )
    if not http.start(int(port)):
        return None
    host = _host_for_url(ctrl.ip, port)
    print("Control page: http://{}/".format(host))
    print("Metrics: http://{}/metrics".format(host))
    return http


def sample_peripherals(ctrl, sensors, display, elapsed_s, now_ms, feed=None):
    """One control sample. Peripheral faults are contained.

    ``feed`` is the watchdog kick. It runs on the way in and on the way out
    so a slow or failed BMP280 or OLED update cannot skip a kick by itself.
    The caller still feeds on the fast 10 ms path.
    """

    def _feed():
        if feed is None:
            return
        try:
            feed()
        except Exception as exc:
            print("wdt: feed failed:", exc)

    _feed()
    internal_c = None
    internal_ok = False
    delta = None
    if sensors is not None:
        try:
            snap = sensors.read()
        except Exception as exc:
            print("bmp280: read failed:", exc)
            snap = None
        if isinstance(snap, dict):
            ctrl.note_sensors(snap, now_ms)
            internal = ctrl.sensor_state.get("internal") or {}
            internal_ok = (
                bool(internal.get("ok")) and internal.get("temp_c") is not None
            )
            internal_c = internal.get("temp_c") if internal_ok else None
            delta = ctrl.pressure_delta_pa
    try:
        ctrl.tick(
            elapsed_s,
            internal_c=internal_c,
            internal_ok=internal_ok,
            pressure_delta_pa=delta,
            now_ms=now_ms,
        )
    except Exception as exc:
        print("fan: tick failed:", exc)
    if display is not None:
        try:
            ctrl.note_oled(display.update(ctrl.status_dict(), now_ms))
        except Exception as exc:
            print("oled: update failed:", exc)
    try:
        gc.collect()
    except Exception as exc:
        print("gc:", exc)
    _feed()


def _open_peripherals(loaded, feed):
    """Open the optional BMP280s and OLED. Returns (sensors, display).

    Both are None when that peripheral is disabled. A missing part returns
    a live object whose status says it failed; it does not raise.
    """
    want_sensor = loaded["internal_enabled"] or loaded["external_enabled"]
    want_oled = loaded["oled_enabled"]
    if not want_sensor and not want_oled:
        print("peripherals: BMP280 and OLED disabled")
        return None, None
    factory = sensors_mod.machine_i2c_factory(
        loaded["i2c_freq"], loaded["i2c_timeout_us"]
    )
    pool = sensors_mod.BusPool(factory)
    hub = None
    oled = None
    if want_sensor:
        try:
            hub = sensors_mod.build_sensors(loaded, pool, feed=feed)
        except Exception as exc:
            print("bmp280: setup failed:", exc)
            hub = None
    if want_oled:
        if feed is not None:
            try:
                feed()
            except Exception:
                pass
        try:
            oled = display_mod.build_oled(loaded, pool)
        except Exception as exc:
            print("oled: setup failed:", exc)
            oled = None
        if feed is not None:
            try:
                feed()
            except Exception:
                pass
    return hub, oled


def main():
    global _ctrl
    led = _make_led()
    loaded, problems = settings_mod.load_settings(config)
    for problem in problems:
        print("config:", problem)
    ctrl = fan.FanController(
        stall_duty_min=loaded["stall_duty_min"],
        stall_rpm_below=loaded["stall_rpm_below"],
        fault_cfg=loaded,
        roles=loaded["fan_roles"],
        exhaust_ratio=loaded["exhaust_ratio"],
        exhaust_offset=loaded["exhaust_offset"],
        pressure_loop=loaded["pressure_loop_enabled"],
        pressure_target_pa=loaded["pressure_target_pa"],
        pressure_loop_gain=loaded["pressure_loop_gain"],
        pressure_trim_max=loaded["pressure_trim_max"],
    )
    ctrl.init_hardware()
    _ctrl = ctrl
    boot_ms = time.ticks_ms()

    # Safe PWM before banners or any network wait: spin-up, then the curve
    # or saved overrides. Hardware holds that duty while Wi-Fi comes up.
    led.value(1)
    overrides_loaded = ctrl.prepare_fans(feed=_feed_wdt)
    _feed_wdt()

    print("Pico thermal fan controller ({} fans, per-fan PWM)".format(fan.FAN_COUNT))
    print(
        "Die curve: {:.0f}°C → {:.0%} … {:.0f}°C → 100%  (ADC4 = die, not ambient)".format(
            fan.MIN_TEMP_C, fan.MIN_SPEED, fan.MAX_TEMP_C
        )
    )
    print(
        "PWM {} @ {} Hz | Tach {}".format(
            ", ".join("F{}=GP{}".format(i + 1, gp) for i, gp in enumerate(fan.PWM_PINS)),
            fan.PWM_FREQ_HZ,
            ", ".join("F{}=GP{}".format(i + 1, gp) for i, gp in enumerate(fan.TACH_PINS)),
        )
    )
    if overrides_loaded:
        print("Loaded overrides from", fan.OVERRIDES_PATH)
    else:
        print("No overrides file — all fans auto")
    print(
        "Airflow: {} exhaust=intake*{:.2f}{:+.2f} pressure_loop={}".format(
            "/".join(ctrl.roles),
            ctrl.exhaust_ratio,
            ctrl.exhaust_offset,
            "on" if ctrl.pressure_loop else "off",
        )
    )

    auth = resolve_auth(loaded["http_user"], loaded["http_password"])
    if auth is None:
        print(AUTH_DISABLED_WARNING)
    else:
        print("HTTP: basic auth enabled")

    mon = wifi.WifiMonitor(
        ctrl,
        ssid=loaded["wifi_ssid"],
        password=loaded["wifi_password"],
        timeout_s=loaded["wifi_timeout_s"],
        retry_s=loaded["wifi_retry_s"],
    )
    if not _wifi_wanted(loaded["wifi_enabled"], loaded["wifi_ssid"]):
        mon.mark_disabled("disabled")
        print("Wi-Fi skipped: disabled or placeholder SSID in config.py")
    else:
        try:
            _feed_wdt()
            print("Wi-Fi: starting radio")
            wlan = _open_wlan()
            _feed_wdt()
            mon.attach(wlan)
            mon.start_attempt(time.ticks_ms())
        except ImportError:
            mon.mark_disabled("unsupported")
            print("Wi-Fi skipped: network module missing (need Pico W MicroPython)")
        except Exception as exc:
            mon.mark_disabled("offline")
            print("Wi-Fi: radio init failed:", exc)

    # Arm only after radio init. wlan.active(True) can block for seconds and
    # must not trip the watchdog. Association itself is polled below, and the
    # loop feeds on every pass, including the fast 10 ms sleep.
    _start_wdt(loaded["wdt_enabled"], loaded["wdt_timeout_ms"])
    _feed_wdt()
    sensor_hub, oled = _open_peripherals(loaded, _feed_wdt)
    _feed_wdt()
    if sensor_hub is not None:
        try:
            ctrl.note_sensors(sensor_hub.snapshot())
        except Exception as exc:
            print("bmp280: status failed:", exc)
    if oled is not None:
        try:
            ctrl.note_oled(oled.status())
        except Exception as exc:
            print("oled: status failed:", exc)

    http = None
    last = time.ticks_ms()
    last_http = last
    last_wifi = last
    last_http_start = None
    uptime_ms = time.ticks_diff(last, boot_ms)
    if uptime_ms < 0:
        uptime_ms = 0
    while True:
        _feed_wdt()
        now = time.ticks_ms()

        if time.ticks_diff(now, last_wifi) >= WIFI_POLL_MS:
            last_wifi = now
            try:
                mon.poll(now)
            except Exception as exc:
                print("wifi:", exc)
        try:
            listening = http is not None and http.is_listening()
        except Exception as exc:
            print("http:", exc)
            listening = False
            http = None
        if http is not None and not listening:
            http = None
        if http is None and ctrl.wifi == "connected":
            if (
                last_http_start is None
                or time.ticks_diff(now, last_http_start) >= HTTP_RESTART_MS
            ):
                last_http_start = now
                try:
                    http = _start_http(
                        ctrl,
                        auth,
                        loaded["http_port"],
                        loaded["metrics_require_auth"],
                    )
                except Exception as exc:
                    print("http:", exc)
                    http = None

        if http is not None and time.ticks_diff(now, last_http) >= HTTP_POLL_MS:
            last_http = now
            try:
                http.poll(now)
            except Exception as exc:
                print("http:", exc)
                try:
                    http.close_listen()
                except Exception:
                    pass
                http = None

        # Blink from the fast path. The sample branch runs only once a second,
        # which is too slow to show a 500 ms phase.
        elapsed_boot = time.ticks_diff(now, boot_ms)
        if elapsed_boot < 0:
            elapsed_boot = 0
        try:
            duty_max = max(ctrl.duties)
            led.value(1 if fan.led_is_on(duty_max, elapsed_boot) else 0)
        except Exception as exc:
            print("led:", exc)

        elapsed_ms = time.ticks_diff(now, last)
        if elapsed_ms < int(fan.SAMPLE_PERIOD_S * 1000):
            time.sleep_ms(10)
            continue
        last = now
        elapsed_s = elapsed_ms / 1000.0
        # Accumulate in a Python int. ticks_diff(now, boot) wraps after ~6 days.
        uptime_ms += elapsed_ms
        # BMP280 and OLED run on this 1 s edge only. The fast path above
        # keeps feeding the watchdog and polling HTTP while they talk.
        try:
            sample_peripherals(
                ctrl, sensor_hub, oled, elapsed_s, now, feed=_feed_wdt
            )
        except Exception as exc:
            print("sample:", exc)
            _feed_wdt()
        ctrl.uptime_s = uptime_ms // 1000

        parts = " ".join(
            "F{}={}={:3.0%}={:4.0f}{}".format(
                i + 1,
                ctrl.modes[i][0],
                ctrl.duties[i],
                ctrl.rpms[i],
                "!" if ctrl.stalls[i] else "",
            )
            for i in range(fan.FAN_COUNT)
        )
        delta = ctrl.pressure_delta_pa
        delta_s = "  dP=--" if delta is None else "  dP={:+.0f}Pa".format(delta)
        if ctrl.pressure_loop_active:
            loop_s = "on"
        elif ctrl.pressure_loop:
            loop_s = "idle"
        else:
            loop_s = "off"
        try:
            print(
                "die={:5.1f}°C ctl={:5.1f}°C src={}{} loop={}  {}  wifi={}".format(
                    ctrl.die_c,
                    ctrl.control_c,
                    ctrl.temp_source,
                    delta_s,
                    loop_s,
                    parts,
                    ctrl.wifi,
                )
            )
        except Exception as exc:
            print("log:", exc)


if __name__ == "__main__":
    try:
        main()
    except KeyboardInterrupt:
        print("\nInterrupted — fail-safe: fans 100%, LED on")
        if _ctrl is not None:
            _ctrl.failsafe()
        try:
            _make_led().value(1)
        except Exception:
            pass
    except Exception as exc:
        print("Error:", exc)
        if _ctrl is not None:
            _ctrl.failsafe()
        try:
            _make_led().value(1)
        except Exception:
            pass
        raise
