thordin9/rp-pico-fan-controller/(commit log)

2026-10-14 docs: add per-fan control and Prometheus design spec
    Capture approved design for individual PWM, web overrides with flash
    persistence, module split, and /metrics before implementation.
2026-10-14 feat: add fan helpers and overrides codec
    Pure thermal/RPM helpers and JSON override codec for host-tested
    per-fan control before wiring Pico hardware.
2026-10-14 feat: add FanController modes and override persistence
    Per-fan auto/manual control with in-memory or flash overrides and
    tick_logic that applies the shared die curve only to auto fans.
2026-10-14 feat: add Pico PWM/tach hardware backend
    PicoHw drives per-fan PWM and tach IRQs; FanController gains spinup,
    tick, and failsafe that does not rewrite overrides.
    [fan.py]
2026-10-14 feat: add HTTP control UI API and metrics route
    Non-blocking server with per-fan POST control, status JSON, inline
    control page, and Prometheus /metrics with request counters.
2026-10-14 feat: wire per-fan controller HTTP and main loop
    Thin main bootstraps FanController, optional Wi-Fi HttpServer, spin-up,
    override load, and the sample/poll loop with fail-safe on exit.
    [main.py]
2026-10-14 docs: update README for per-fan PWM and Prometheus
    Document separate PWM pins, 10 kΩ pull-ups, control API, /metrics,
    flash file set, and host unit tests; include implementation plan.
2026-10-19 fix: keep fan control alive across Wi-Fi, HTTP, and watchdog
    Monitor station association without blocking the sample loop, arm the
    RP2040 watchdog after radio init, and bring fans up before any network
    wait. HTTP Basic Auth covers every route, out-of-range duty returns 400,
    and stall, tach debounce, and averaged die temperature are reported.
    [config.py, fan.py, main.py, metrics.py, test_fan_logic.py, test_main_helpers.py, test_metrics.py, test_web_handlers.py]
2026-10-19 fix: keep tach IRQ and HTTP buffers safe on the RP2040
    Use the C ticks_diff in the pin handler so a microsecond wrap cannot
    allocate, accept unpadded Basic tokens, and assemble requests in a
    bytearray. If connect() is already associated, report connected
    immediately.
    [fan.py, test_fan_logic.py, test_web_handlers.py, test_wifi.py, web.py, wifi.py]
2026-10-19 feat: add optional BMP280 sensors, OLED, and intake bias
    BMP280 temperature and pressure can drive the auto curve and report
    enclosure pressure, with chip id 0x58 required. Peripherals stay off
    unless enabled and a missing part cannot stop the fans.
    [bmp280.py, config.py, display.py, fake_i2c.py, fan.py, main.py, metrics.py, sensors.py]
2026-10-19 feat: default both BMP280s to 0x76 on separate buses
    Put the external sensor on I2C1 and turn the pressure trim on.
    Idle exhaust stays at 18% so it does not sit on the stall threshold,
    and a missing sensor falls back to the static intake/exhaust ratio.
    [config.py, display.py, fan.py, main.py, metrics.py, sensors.py, settings.py, test_airflow.py]
2026-10-19 feat: add printable Pico W and BMP280 enclosures
    Parametric OpenSCAD cases for the Pico W with the 0.91" OLED and for
    the internal and external BMP280 modules. The Pico case has separate
    INT and EXT cable exits: I2C0 (GP4 SDA / GP5 SCL) shared with the OLED,
    and I2C1 (GP6 SDA / GP7 SCL) for the external sensor. Both sensors stay
    at the hardwired address 0x76, so each housing leaves with a 4-wire cable.
    [bmp280_ext_body.stl, bmp280_ext_lid.stl, bmp280_housing.scad, bmp280_int_body.stl, bmp280_int_lid.stl, dimensions.scad, lib.scad, pico_case.scad]
2026-10-19 feat: reject implausible sensor readings and contain faults
    Keep out-of-range, stuck, stale, and impossible tach or pressure-delta
    samples from driving the fan curve or the pressure loop, and report the
    latched fault on the page, status JSON, OLED, and Prometheus.
    Validate config at boot, write overrides atomically, and stop a subsystem
    exception from halting fan control or the watchdog.
    [bmp280.py, config.py, display.py, fan.py, faults.py, main.py, metrics.py, sensors.py]
2026-10-19 docs: rewrite the manual to match the current firmware
    Split the README into a quick start plus wiring, control-flow, config,
    API, and troubleshooting pages. Pin diagrams now use Pico W physical
    pin numbers, and a doc test checks config keys and metric names.
2026-10-19 feat: add parametric FreeCAD models of the enclosure parts
    Generate the Pico W case and both BMP280 housings as PartDesign
    bodies driven by a spreadsheet of the OpenSCAD dimensions. The
    headless build checks that every sketch is fully constrained and
    that each solid matches the OpenSCAD mesh.
    [bmp280_ext_body.FCStd, bmp280_ext_body.step, bmp280_ext_body.stl, bmp280_ext_lid.FCStd, bmp280_ext_lid.step, bmp280_ext_lid.stl, bmp280_int_body.FCStd, bmp280_int_body.step]
2026-10-19 feat: shrink the indoor enclosures and make the wall mount detachable
    Drop the rain awning, drip-loop geometry, radiation louvers, and fixed
    ears. INT and EXT share one compact vented housing. The OLED window is
    a through opening with a viewing chamfer, and an optional slide-on
    bracket replaces the mounting tabs.
    [bmp280_ext_body.FCStd, bmp280_ext_body.step, bmp280_ext_body.stl, bmp280_ext_lid.FCStd, bmp280_ext_lid.step, bmp280_ext_lid.stl, bmp280_housing.scad, bmp280_int_body.FCStd]
2026-10-19 fix: open the BMP280 cable exit and account for all six pins
    The sensor-body cutter was centred on the outer face, so it stopped
    0.2 mm short of the cavity and the probe only saw the blind recess.
    The exit is now a 16.5 by 6.0 mm through hole with the strain bar on
    the top edge, sized for a 6-wire Dupont lead.
    CSB goes to 3V3 and SDO to GND with a wire: a 6-wire cable, or
    jumpers soldered on the module. Pico INT and EXT openings are 8 by
    5 mm, and the case cleats sit above the slots so they no longer
    choke the inner mouth.
    [bmp280_ext_body.FCStd, bmp280_ext_body.step, bmp280_ext_body.stl, bmp280_ext_lid.FCStd, bmp280_ext_lid.step, bmp280_ext_lid.stl, bmp280_housing.scad, bmp280_int_body.FCStd]
2026-10-22 fix: fit the BMP280 housing to the purple module and snap the lids
    The printed body was sized for a 21 x 18 mm board, so a 15 x 11.5 mm
    GY-BMP280 sat in one corner. The cavity is now that module plus 0.45 mm
    on the sides and back, with a header bay and a cable exit on the pin
    row. Cantilever fingers replace the stiff skirt ridge on the sensor
    lid and the Pico lid.
    [bmp280_ext_body.FCStd, bmp280_ext_body.step, bmp280_ext_body.stl, bmp280_ext_lid.FCStd, bmp280_ext_lid.step, bmp280_ext_lid.stl, bmp280_housing.scad, bmp280_int_body.FCStd]
